patito-lab/Hydroponics/hardware/README.md

# Hardware

Full BOM: `Hydroponics_BOM_v1.xlsx` (this folder), Summary tab has phase subtotals and a budget/premium (DFRobot vs. Atlas Scientific) toggle.

## Summary

[paste the Summary tab here as a markdown table so it's viewable without downloading the spreadsheet]

## Physical build

- Reservoir: Veradek Demi planter, slim DWC, ~30" x 6" x 8" interior
- Sites: four 3" net pots (basil, cilantro, parsley, chives)
- Lid: 3mm Komatex foam PVC sheet, reinforced with PVC strips as stiffening ribs, bonded with PVC solvent cement

(wiring diagram and build photos to add here as the build progresses)
