patito-lab/Hydroponics/docs/decisions/005-reservoir-opacity.md

# 005: Opaque reservoir and stock bottles

**Date:** 26Jul26
**Status:** Accepted

## Context

Need to pick a hydroponic method and containers to support it.

## Options considered

Ebb/flow, NFT, and DWC for hydroponics methods. Clear vs opaque containers. Types of plastic

## Decision

DWC selected. Using plastic window planter box. 1/8" PVC for lid. HDPE for dosing bottles

## Why

Window box is cheap-ish, the right size for my space, and looks decent. Opaque materials are needed as light entering a nutrient reservoir promotes algae growth in the solution, which competes with the plants for nutrients and can clog pump inlets and tubing. Blocking light out is standard practice in DWC systems for this reason. Cover helps block light and is needed for net pots to rest on. 1/8" PVC is cheap and easy to cut. Ribs making a T-beam will be used to strengthen it. Vertical ribs near the walls of the planter box give the lid something to rest on and provide a mounting point for tubing + sensors.
