patito-lab/Hydroponics/docs/Hydroponics_Pinout_v1.xlsx

Sheet: CN7
CN7 pin assignment
NUCLEO-F446RE morpho connector, physical pin order.
Pin | Signal | Function | Category | Notes
1 | PC10 | Bottle A float | Input | Level switch, dosing bottle A. Internal pull-up, switch to GND. EXTI10.
2 | PC11 | Bottle B float | Input | Level switch, dosing bottle B. Internal pull-up, switch to GND. EXTI11.
3 | PC12 | Bottle C float | Input | Level switch, dosing bottle C. Internal pull-up, switch to GND. EXTI12.
4 | PD2 | Bottle D float | Input | Level switch, dosing bottle D. Internal pull-up, switch to GND. EXTI2.
5 | VDD | 3.3V | Power
6 | E5V | 5V input | Power | External 5V supply input when not USB powered. Set JP5 accordingly.
7 | BOOT0 | BOOT0 | Reserved | Pulled low on Nucleo.
8 | GND | Ground | Power
9 | NC |  | NC
10 | NC |  | NC
11 | NC |  | NC
12 | IOREF | IO reference | Power
13 | PA13 | SWDIO | Debug | ST-Link SWD.
14 | RESET | NRST | Reserved
15 | PA14 | SWCLK | Debug | ST-Link SWD.
16 | +3V3 | 3.3V | Power
17 | PA15 | Tank float, max 5.5in | Input | Upper level, net pot bottom. JTDI at reset; free only with SW-only debug. EXTI15.
18 | +5V | 5V | Power
19 | GND | Ground | Power
20 | GND | Ground | Power
21 | PB7 | Tank float, refill 3.5in | Input | Refill trigger level. EXTI7.
22 | GND | Ground | Power
23 | PC13 | B1 user button | Reserved | Onboard blue button.
24 | VIN | 7-12V input | Power
25 | PC14 | OSC32_IN | Reserved | Keep free for LSE crystal (RTC scheduling in V2).
26 | NC |  | NC
27 | PC15 | OSC32_OUT | Reserved | Keep free for LSE crystal (RTC scheduling in V2).
28 | PA0 | Spare | Free | ADC123_IN0. Also TIM2_CH1.
29 | PH0 | OSC_IN | Reserved | 8 MHz from ST-Link MCO.
30 | PA1 | Spare | Free | ADC123_IN1. Also TIM2_CH2.
31 | PH1 | OSC_OUT | Reserved
32 | PA4 | SD card CS | SPI | Software-controlled CS. Do not use hardware NSS; FatFs holds CS low across multi-byte transactions.
33 | VBAT | Battery | Power
34 | PB0 | Tank float, min 2.0in | Input | Low level, pump protection. Costs ADC1_IN8. EXTI0.
35 | PC2 | Analog 3 | Analog | ADC123_IN12. Spare analog sensor (light sensor in V2).
36 | PC1 | Analog 2, EC | Analog | ADC123_IN11. Target 1.0-1.4 mS/cm for herbs.
37 | PC3 | Spare | Free | ADC123_IN13.
38 | PC0 | Analog 1, pH | Analog | ADC123_IN10.

Sheet: CN10
CN10 pin assignment
NUCLEO-F446RE morpho connector, physical pin order.
Pin | Signal | Function | Category | Notes
1 | PC9 | Spare | Free
2 | PC8 | LED, tank red | Output | 220 ohm series.
3 | PB8 | Spare | Free | I2C1_SCL if I2C is retained for expander or EZO modules.
4 | PC6 | LED, tank yellow | Output | 220 ohm series.
5 | PB9 | Spare | Free | I2C1_SDA if I2C is retained for expander or EZO modules.
6 | PC5 | Spare | Free | ADC12_IN15.
7 | AVDD | Analog 3.3V | Power
8 | U5V | USB 5V | Power
9 | GND | Ground | Power
10 | NC |  | NC
11 | PA5 | SPI1_SCK | SPI | Also drives LD2 via SB21. Remove SB21 if SD card is marginal at clock speed.
12 | PA12 | Air pump on/off | Output | USB_DP, unused on Nucleo-64. Low-side MOSFET drive.
13 | PA6 | SPI1_MISO | SPI
14 | PA11 | Pump 4 on/off | Output | TIM1_CH4. Bottle D (pH Up). AO3400A low-side.
15 | PA7 | SPI1_MOSI | SPI
16 | PB12 | LED, bottle A red | Output | 220 ohm series.
17 | PB6 | LED, system red | Output | 220 ohm series.
18 | PB11 | Spare | Free
19 | PC7 | LED, tank green | Output | 5V rail low-side sink, 270-330 ohm. 5V tolerant.
20 | GND | Ground | Power
21 | PA9 | Pump 2 on/off | Output | TIM1_CH2. Bottle B (Masterblend + Epsom). AO3400A low-side.
22 | PB2 | LED, bottle C green | Output | 5V rail low-side sink. BOOT1: reads high at reset, harmless since BOOT0 is pulled low.
23 | PA8 | Pump 1 on/off | Output | TIM1_CH1. Bottle A (calcium nitrate). AO3400A low-side.
24 | PB1 | LED, bottle C red | Output | 220 ohm series.
25 | PB10 | LED, system green | Output | 5V rail low-side sink, 270-330 ohm. 5V tolerant.
26 | PB15 | LED, bottle B green | Output | 5V rail low-side sink, 270-330 ohm. 5V tolerant.
27 | PB4 | LED, bottle D red | Output | NJTRST; free only with SW-only debug. 220 ohm series.
28 | PB14 | LED, bottle B red | Output | 220 ohm series.
29 | PB5 | LED, bottle D green | Output | 5V rail low-side sink, 270-330 ohm. 5V tolerant.
30 | PB13 | LED, bottle A green | Output | 5V rail low-side sink, 270-330 ohm. 5V tolerant.
31 | PB3 | SWO | Debug | Trace output. Requires Trace Asynchronous SW debug setting.
32 | AGND | Analog ground | Power
33 | PA10 | Pump 3 on/off | Output | TIM1_CH3. Bottle C (pH Down). AO3400A low-side.
34 | PC4 | Spare | Free | ADC12_IN14.
35 | PA2 | VCP TX | Reserved | USART2 to ST-Link virtual COM port.
36 | NC |  | NC
37 | PA3 | VCP RX | Reserved | USART2 to ST-Link virtual COM port.
38 | NC |  | NC

Sheet: By Function
Assignments by subsystem
Firmware-side view. Same data as the connector sheets, grouped by module.
Subsystem | Signal | Port pin | Connector | Header pin | Notes
Tank level | Max level, 5.5in | PA15 | CN7 | 17 | Net pot bottom. Overfill limit.
 | Refill trigger, 3.5in | PB7 | CN7 | 21 | Starts refill routine.
 | Minimum, 2.0in | PB0 | CN7 | 34 | Inhibits dosing and air pump.
Bottle level | Bottle A, cal nitrate | PC10 | CN7 | 1
 | Bottle B, Masterblend | PC11 | CN7 | 2
 | Bottle C, pH Down | PC12 | CN7 | 3
 | Bottle D, pH Up | PD2 | CN7 | 4
Dosing pumps | Pump 1, bottle A | PA8 | CN10 | 23 | TIM1_CH1.
 | Pump 2, bottle B | PA9 | CN10 | 21 | TIM1_CH2.
 | Pump 3, bottle C | PA10 | CN10 | 33 | TIM1_CH3.
 | Pump 4, bottle D | PA11 | CN10 | 14 | TIM1_CH4.
Aeration | Air pump | PA12 | CN10 | 12
Analog | pH | PC0 | CN7 | 38 | ADC123_IN10.
 | EC | PC1 | CN7 | 36 | ADC123_IN11.
 | Spare analog | PC2 | CN7 | 35 | ADC123_IN12.
Status LEDs | Tank red | PC8 | CN10 | 2
 | Tank yellow | PC6 | CN10 | 4
 | Tank green | PC7 | CN10 | 19
 | Bottle A red | PB12 | CN10 | 16
 | Bottle A green | PB13 | CN10 | 30
 | Bottle B red | PB14 | CN10 | 28
 | Bottle B green | PB15 | CN10 | 26
 | Bottle C red | PB1 | CN10 | 24
 | Bottle C green | PB2 | CN10 | 22
 | Bottle D red | PB4 | CN10 | 27
 | Bottle D green | PB5 | CN10 | 29
 | System red | PB6 | CN10 | 17
 | System green | PB10 | CN10 | 25
SD logger | SPI1_SCK | PA5 | CN10 | 11 | Shared with LD2 via SB21.
 | SPI1_MISO | PA6 | CN10 | 13
 | SPI1_MOSI | PA7 | CN10 | 15
 | Chip select | PA4 | CN7 | 32 | Software CS.

Sheet: Spares
Unassigned pins and budget
Port pin | Connector | Header pin | ADC capable | Alternate functions
PA0 | CN7 | 28 | Yes | ADC123_IN0, TIM2_CH1
PA1 | CN7 | 30 | Yes | ADC123_IN1, TIM2_CH2
PC3 | CN7 | 37 | Yes | ADC123_IN13
PC4 | CN10 | 34 | Yes | ADC12_IN14
PC5 | CN10 | 6 | Yes | ADC12_IN15
PC9 | CN10 | 1 | No | TIM3_CH4, I2S_CKIN
PB11 | CN10 | 18 | No | TIM2_CH4, I2C2_SDA
PB8 | CN10 | 3 | No | I2C1_SCL, TIM4_CH3, CAN1_RX
PB9 | CN10 | 5 | No | I2C1_SDA, TIM4_CH4, CAN1_TX
Budget
Float switch inputs | 7
Digital outputs (pumps, air, LEDs) | 18
Analog inputs | 3
SPI (SD logger, incl. CS) | 4
Total assigned | 32
Unassigned and usable | 9
Notes
Counts are driven by the Category column on the CN7 and CN10 sheets. Recategorizing a pin there updates them.
PA15 and PB4 require SYS Debug set to Trace Asynchronous SW in CubeMX. Full JTAG reclaims both, plus PB3.
PC14 and PC15 are held free for an LSE crystal, on the assumption V2 grow lights need a day/night schedule.
PB8 and PB9 are held free so I2C1 remains available for an MCP23017 expander or Atlas Scientific EZO modules.
Green LEDs sink from the 5V rail. Every pin used that way is 5V tolerant. Do not extend the scheme to PA4 or PC0-PC5.
Sensor return current must not share a path with pump return current. Run MOSFET grounds to the supply directly.
