patito-lab/Hydroponics/docs/pump_driver_v1.jpg

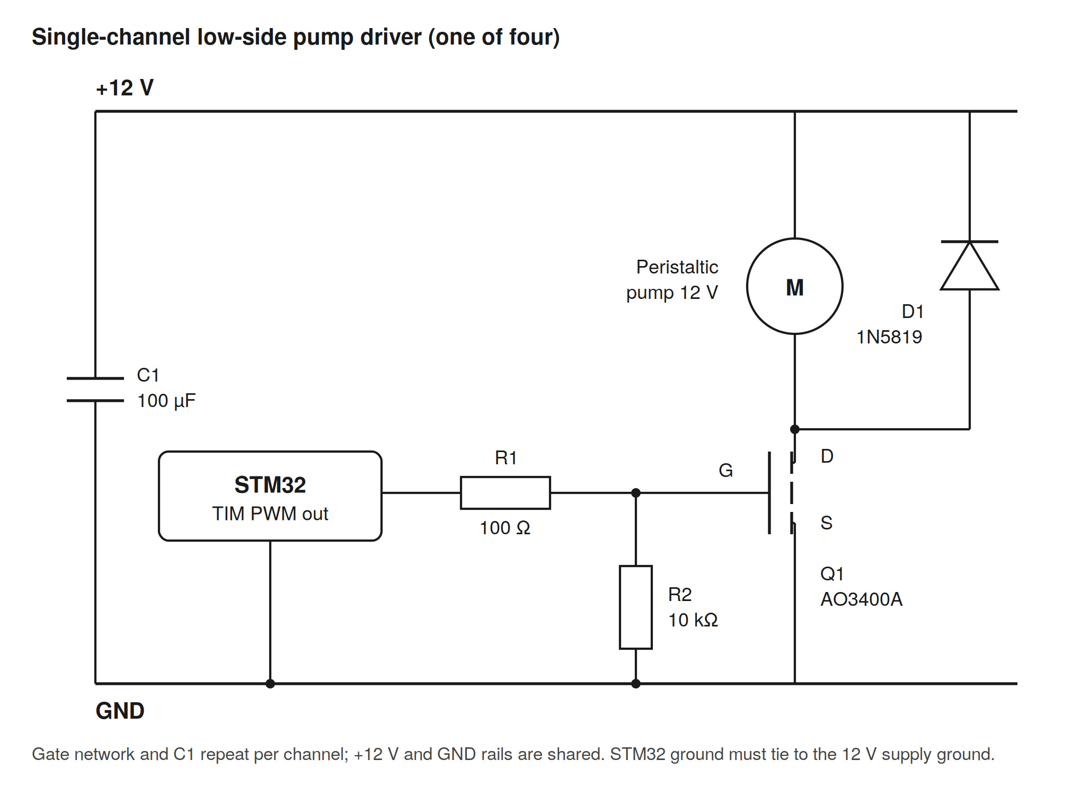
docs/pump_driver_v1.jpg
