patito-lab/Hydroponics/docs/Hydroponics_BOM_v1.xlsx

Sheet: Summary
Kitchen Hydroponics — Bill of Materials (v1)
Recirculating DWC base build. Prices are single-unit estimates in USD, as of Jul 2026 — verify before ordering.
How to use
Include column (yellow, on the BOM tab): 1 = counted in totals, 0 = excluded. Toggle it to match what you're actually buying.
Budget-path pH/EC sensors are ON by default; the two Atlas precision rows are OFF. The Atlas parts REPLACE the DFRobot pH/EC parts — don't run both.
COST SUMMARY — included items only
Build phase | Cost ($) | Bought
V1 — Compute, drivers, power | $147.00 | Amazon | 400
V1.5 — Sensing, dosing, aeration | $237.40 | DFR | 110
V2 — Environmental + lighting | $44.00 | Home Depot | 140
V3 — Wireless node (per unit) | $0.00
Mechanical & plumbing | $92.00
Consumables (not plants) | $81.00
Bench tools | $0.00
TOTAL (included) | $601.40 | Total | 650
For the precision build: set the two Atlas rows to Include=1 and the DFRobot pH/EC rows to Include=0. Net delta is about +$296.
Price basis: single-unit estimates from ST, DigiKey, DFRobot, Atlas Scientific, Amazon, and PowerGrow listings (Jul 2026). Treat as planning figures; check current price and shipping at order time.

Sheet: BOM
Phase | Subsystem | Item / spec | Bought | Qty | Unit $ | Include | Line $ | Vendor | Link | Notes
V1 | Compute | STM32 Nucleo-F446RE dev board | 1 | 1 | $25.00 | 1 | $25.00 | ST eStore / DigiKey | https://estore.st.com/en/nucleo-f446re-cpn.html | Onboard ST-LINK, no separate programmer. ~$25 from ST/DigiKey, ~$42 from Amazon/eBay resellers.
V1 | Compute | USB Mini-B cable (for ST-LINK) |  | 1 | $6.00 | 1 | $6.00 | Amazon |  | Skip if you already have one.
V1 | Compute | Breadboards (half/full) |  | 2 | $6.00 | 1 | $12.00 | Amazon
V1 | Compute | Jumper wire assortment (M-M / M-F / F-F) |  | 1 | $7.00 | 1 | $7.00 | Amazon
V1 | Compute | Perfboard / protoboard pack | 1 | 1 | $10.00 | 1 | $10.00 | Amazon |  | For semi-permanent build once the breadboard version works.
V1 | Compute | Male header strips (2.54mm) | 1 | 1 | $7.00 | 1 | $7.00 | Amazon
V1 | Compute | Screw terminal blocks (assortment) | 1 | 1 | $9.00 | 1 | $9.00 | Amazon
V1 | Driver | IRLZ44N logic-level MOSFETs (10-pk) | 1 | 1 | $9.00 | 1 | $9.00 | Amazon |  | Pump switching; logic-level gate drives from 3.3V.
V1 | Driver | Small MOSFETs AO3400 / 2N7000 (asst) | 1 | 1 | $8.00 | 1 | $8.00 | Amazon |  | Small loads.
V1 | Driver | 1N4007 diodes (100-pk) | 1 | 1 | $7.00 | 1 | $7.00 | Amazon |  | Flyback across every pump motor.
V1 | Driver | Resistor kit (incl 4.7k, gate Rs) | 1 | 1 | $10.00 | 1 | $10.00 | Amazon |  | 4.7k is the DS18B20 1-Wire pull-up.
V1 | Driver | Capacitor assortment (decoupling + bulk) | 1 | 1 | $12.00 | 1 | $12.00 | Amazon
V1 | Power | 12V DC PSU, 5A+ | 1 | 1 | $16.00 | 1 | $16.00 | Amazon |  | Sized to run pumps + 12V LED together.
V1 | Power | Buck converter LM2596 (3-pk) | 1 | 1 | $9.00 | 1 | $9.00 | Amazon |  | 5V/3.3V logic rails. Skip if powering Nucleo over USB during dev.
V1 | Power | Multi-channel MOSFET board (optional) |  | 1 | $12.00 | 0 | $0.00 | Amazon |  | Convenience alternative to discrete MOSFETs above. Pick one approach, not both.
V1.5 | Sensing (budget) | DFRobot Gravity pH Kit V2 (SEN0161-V2) | 1 | 1 | $39.50 | 1 | $39.50 | DFRobot / DigiKey | https://www.digikey.com/en/products/detail/dfrobot/SEN0161-V2/9608223 | Probe + conditioning board + cal solutions.
V1.5 | Sensing (budget) | DFRobot Gravity EC sensor K=1 (DFR0300) | 1 | 1 | $69.90 | 1 | $69.90 | DFRobot | https://www.dfrobot.com/topic-282.html | EC tracks nutrient strength more directly than TDS; prefer over SEN0244.
V1.5 | Sensing (budget) | Waterproof DS18B20 solution-temp probe | 1 | 1 | $9.00 | 1 | $9.00 | Amazon / DigiKey |  | Required for temp compensation on pH and EC. Not optional.
V1.5 | Sensing (budget) | Reservoir float switch (level) | 1 | 1 | $8.00 | 1 | $8.00 | Amazon |  | Basic low/refill detection.
V1.5 | Sensing (budget) | Ultrasonic level JSN-SR04T (optional) |  | 1 | $11.00 | 0 | $0.00 | Amazon |  | Continuous level for volume-based dosing math. Alternative to float switch.
V1.5 | Sensing (precision) | Atlas Scientific EZO-pH Kit |  | 1 | $175.00 | 0 | $0.00 | Atlas Scientific | https://atlas-scientific.com/kits/ph-kit/ | Isolated, I2C. REPLACES the DFRobot pH row. Verify current price (~$175).
V1.5 | Sensing (precision) | Atlas Scientific EZO-EC Kit K1.0 (EC-KIT-1.0) |  | 1 | $229.99 | 0 | $0.00 | Atlas Scientific | https://atlas-scientific.com/kits/conductivity-k-1-0-kit/ | Isolated, I2C. REPLACES the DFRobot EC row. Also solves probe cross-interference.
V1.5 | Dosing | 12V peristaltic dosing pump (Kamoer NKP / INTLLAB) | 1 | 4 | $18.00 | 1 | $72.00 | Amazon | https://www.amazon.com/Kamoer-Peristaltic-Hydroponics-Nutrient-Analytical/dp/B07GWJ78FN | Nutrient A, Nutrient B, pH Down, pH Up. Start with 3 and defer pH Up if budget-limited.
V1.5 | Dosing | Silicone dosing tubing 2x4mm (roll) | 1 | 1 | $9.00 | 1 | $9.00 | Amazon
V1.5 | Dosing | Inline check valves (dosing lines) | 1 | 4 | $2.50 | 1 | $10.00 | Amazon |  | Stop siphon-back into the stock bottles.
V1.5 | Aeration | Air pump | 1 | 1 | $12.00 | 1 | $12.00 | Amazon |  | DWC aeration.
V1.5 | Aeration | Air stone(s) + airline tubing |  | 1 | $8.00 | 1 | $8.00 | Amazon
V1.5 | Dosing | Submersible pump (optional) |  | 1 | $12.00 | 0 | $0.00 | Amazon |  | Only if you add recirculation or switch to NFT.
V2 | Env sensing | SHT31 temp/humidity breakout |  | 1 | $14.00 | 1 | $14.00 | Adafruit / Amazon |  | Better RH accuracy than BME280. Pick BME280 only if you want barometric pressure.
V2 | Env sensing | BH1750 ambient light (lux) sensor |  | 1 | $5.00 | 1 | $5.00 | Amazon |  | Cheap grow-light feedback proxy.
V2 | Env sensing | PAR / quantum sensor, Apogee (optional) |  | 1 | $220.00 | 0 | $0.00 | Apogee |  | Accurate umol data; only worth it if you need PAR. Expensive.
V2 | Lighting | 12V full-spectrum LED grow strip / small panel |  | 1 | $25.00 | 1 | $25.00 | Amazon |  | Drive via MOSFET PWM for photoperiod and dimming.
V2 | Lighting | Aluminum LED channel + heatsinking (optional) |  | 1 | $12.00 | 0 | $0.00 | Amazon |  | If you go with a higher-power strip.
V3 | Wireless | STM32 Nucleo-WB55RG board (per node) |  | 1 | $50.00 | 0 | $0.00 | ST / DigiKey | https://www.digikey.com/en/products/detail/stmicroelectronics/NUCLEO-WB55RG/13684823 | BLE on your CubeIDE toolchain (no ESP32 stack). P-NUCLEO-WB55 pack w/ USB dongle ~$77.
Mech | Reservoir | Opaque food-grade reservoir (5-gal bucket / tote) | 1 | 1 | $12.00 | 1 | $12.00 | Hardware store |  | Opaque prevents algae; a clear tank grows it.
Mech | Reservoir | Lid + net pots + neoprene collars |  | 1 | $14.00 | 1 | $14.00 | Amazon
Mech | Media | Clay pebbles (hydroton) |  | 1 | $16.00 | 1 | $16.00 | Amazon |  | Growing medium, not a plant.
Mech | Media | Rockwool starter cubes |  | 1 | $10.00 | 1 | $10.00 | Amazon |  | Seed-start medium, not a plant.
Mech | Plumbing | Stock bottles for nutrient / pH solutions | 1 | 4 | $3.00 | 1 | $12.00 | Amazon |  | Dosing pumps draw from these.
Mech | Plumbing | Grommets / bulkhead fittings |  | 1 | $10.00 | 1 | $10.00 | Amazon
Mech | Enclosure | Project enclosure + cable glands + standoffs |  | 1 | $18.00 | 1 | $18.00 | Amazon |  | Mount electronics clear of splashes.
Consum | Nutrients | Masterblend 4-18-38 combo kit, 2.5 lb (w/ CalNit + Epsom) | 1 | 1 | $25.00 | 1 | $25.00 | Amazon / PowerGrow | https://www.amazon.com/MASTERBLEND-4-18-38-Complete-Combo-Fertilizer/dp/B071L15G5Y | 2-part scheme, ~180 gal. Keep CalNit stock separate from A/B or it precipitates.
Consum | pH control | pH Down (phosphoric acid) | 1 | 1 | $12.00 | 1 | $12.00 | Amazon
Consum | pH control | pH Up (potassium hydroxide / carbonate) | 1 | 1 | $12.00 | 1 | $12.00 | Amazon
Consum | Calibration | pH cal buffers (4.0 & 7.0) | 1 | 1 | $12.00 | 1 | $12.00 | Amazon
Consum | Calibration | EC cal standard (1413 uS/cm) | 1 | 1 | $10.00 | 1 | $10.00 | Amazon
Consum | Calibration | pH probe storage solution (KCl) | 1 | 1 | $10.00 | 1 | $10.00 | Amazon
Bench | Tools | Soldering iron + solder |  | 1 | $30.00 | 0 | $0.00 | — |  | Default off; skip anything you own.
Bench | Tools | Wire strippers | 1 | 1 | $12.00 | 0 | $0.00 | —
Bench | Tools | Heat-shrink assortment |  | 1 | $8.00 | 0 | $0.00 | —
Bench | Tools | Multimeter | 1 | 1 | $25.00 | 0 | $0.00 | —
Bench | Tools | Logic analyzer (Saleae clone) |  | 1 | $12.00 | 0 | $0.00 | — |  | Handy for I2C/SPI debug; Nucleo VCP covers most serial.
