patito-lab/Hydroponics/docs/status_led_wiring_v1.jpg

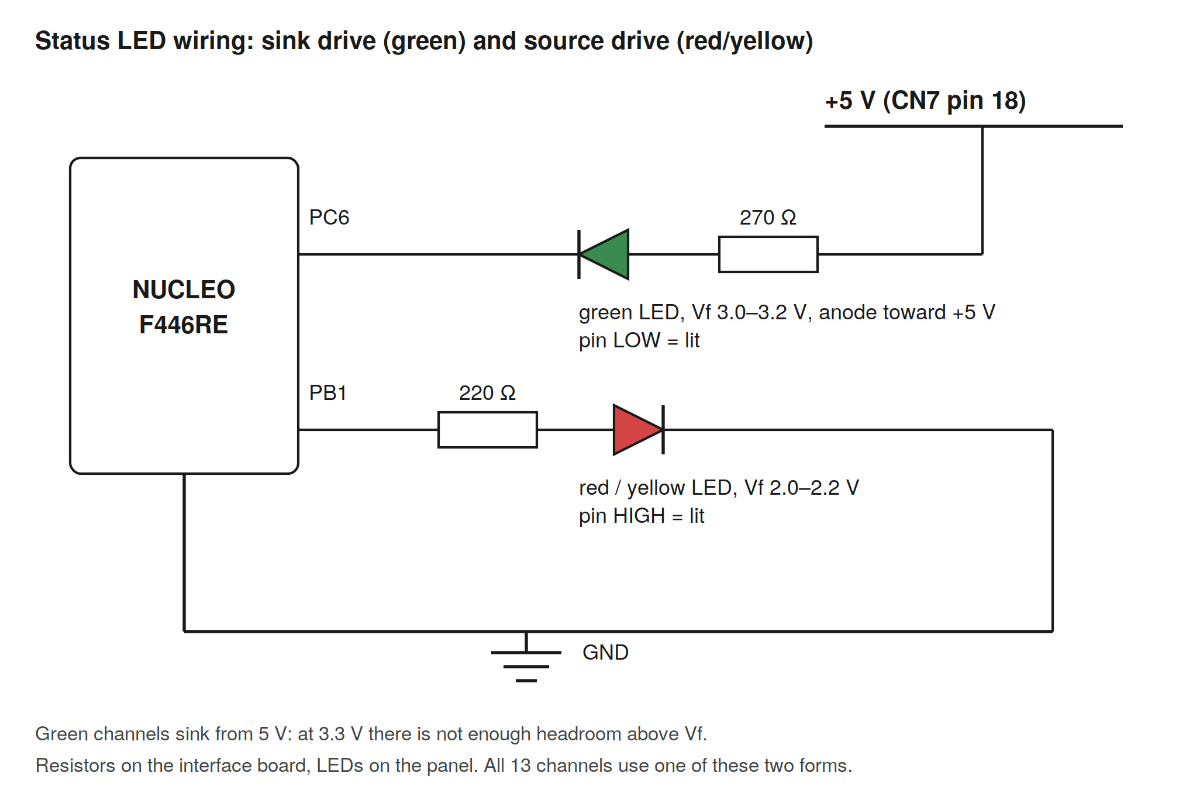
docs/status_led_wiring_v1.jpg
