patito-lab/Hydroponics/docs/Motor_Characterization.xlsx

time | Press | P1 | P2 | P3 | P4 | time | P1 | P2 | P3 | P4
0.5 | 1 | 0.9 | 0.8 | 0.9 | 0.9 | 0.5
0.5 | 2 | 0.8 | 0.8 | 0.8 | 0.9 | 1
0.5 | 3 | 0.8 | 0.8 | 0.8 | 0.8 | 5
0.5 | 4 | 0.8 | 0.8 | 0.8 | 0.8 | 10
0.5 | 5 | 0.9 | 0.6 | 0.7 | 0.8 | 15
1 | 6 | 1.6 | 1.5 | 1.6 | 1.7 | 30
1 | 7 | 1.6 | 1.6 | 1.7 | 1.6 | 60
1 | 8 | 1.7 | 1.7 | 1.7 | 1.7
1 | 9 | 1.6 | 1.5 | 1.5 | 1.6
1 | 10 | 1.7 | 1.6 | 1.5 | 1.6
5 | 11 | 8.4 | 7.7 | 10.6 | 8.2
5 | 12 | 8.1 | 7.8 | 8.0 | 8.1
5 | 13 | 8.2 | 7.9 | 8.0 | 8.3
5 | 14 | 8.2 | 7.8 | 8.0 | 8.2
5 | 15 | 8.4 | 7.9 | 8.0 | 8.3
5 | 16 | 8.1 | 7.8 | 7.9 | 8.3
5 | 17 | 8.2 | 7.7 | 7.9 | 8.1
5 | 18 | 8.4 | 7.8 | 8.0 | 8.6
5 | 19 | 8.1 | 7.7 | 8.1 | 8.3
5 | 20 | 8.2 | 7.9 | 8.1 | 8.4
10 | 21 | 16.7 | 15.6 | 15.9 | 16.3
10 | 22 | 16.6 | 15.6 | 15.8 | 16.4
10 | 23 | 16.7 | 15.6 | 15.9 | 16.5
10 | 24 | 16.4 | 15.7 | 15.9 | 16.5
10 | 25 | 16.3 | 15.6 | 15.8 | 16.4
15 | 26 | 25.2 | 23.3 | 23.8 | 24.4
15 | 27 | 25.1 | 23.2 | 23.8 | 24.5
15 | 28 | 25.3 | 23.2 | 23.9 | 24.7
15 | 29 | 25.3 | 23.2 | 23.9 | 24.8
15 | 30 | 25.2 | 23.2 | 24 | 24.7
30 | 31 | 50.7 | 46.4 | 47.8 | 48.5
30 | 32 | 51.1 | 46.2 | 47.7 | 49.2
30 | 33 | 51.1 | 46.1 | 46.7 | 49.1
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
