patito-lab/Hydroponics/firmware/firmware.ioc

Mcu.UserName=STM32F446RETx
PA5.GPIO_Label=LD2
PA5.Signal=GPIO_Output
PA13.Signal=SYS_JTMS-SWDIO
PA14.Signal=SYS_JTCK-SWCLK
PC13.GPIO_Label=B1
PC13.Signal=GPXTI13
PH0-OSC_IN.Signal=RCC_OSC_IN
PH1-OSC_OUT.Signal=RCC_OSC_OUT
