patito-lab/Hydroponics/(commit log)

2026-08-01 Generate STM32F446RE baseline project (NUCLEO-F446RE, HAL, Advanced structure)
2026-08-08 add 007 decision on LED's and document pin out
2026-08-10 update GPIO pinout, add schematics, setup all LED's in code
    [Hydroponics_BOM_v1.xlsx, Hydroponics_Pinout_v1.xlsx]
2026-08-16 fixed LED setup, configured switches, configured main loop to integrate both modules
    [firmware.ioc, level_check.c, level_check.h, status_LEDs.c, status_LEDs.h]
2026-08-18 added motor control code and dose calc. Dose calc is a test only for characterization currently. Included pump characterization data, analysis pending.
    [Motor_Characterization.xlsx]
